ArcBotics/Hexy/README

Hexy the Hexapod is licensed under a Creative Commons Attribution ShareAlike 3.0 United States License.
The full terms of this license can be read at:
http://creativecommons.org/licenses/by-sa/3.0/
