ArcBotics/Hexy/Hexy.SLDASM

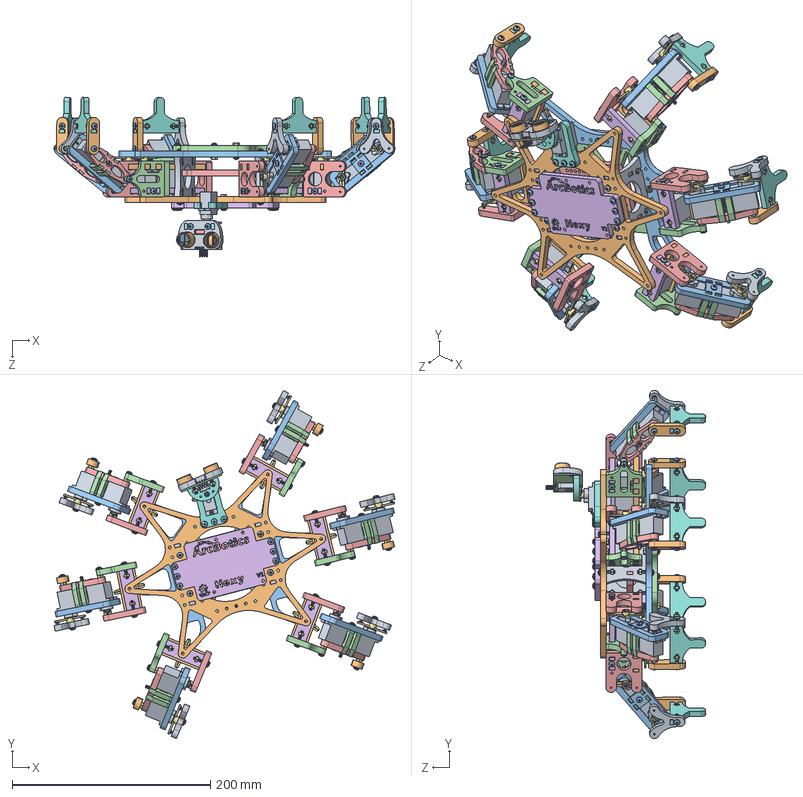
[picture p1: CAD file, 2012-09-01]
Hexy.SLDASM
344.1 x 351.4 x 161.0 mm
Servo x 19
Hip_top_side x 6
Thigh_top x 6
Thigh_middle x 12
Thigh_bottom x 6
M3_35mm_machine_screw x 6
M3_machine_nut x 66
Foot x 6
Calf_horn x 6
Calf_pivot x 6
M3_14mm_machine_screw x 60
Hip_back_side x 6
Hip_horn_side x 6
Hip_pivot_side x 6
Micro Servo Horn Arm x 19
#2_1-4in_sheetmetal_screw x 52
Body_brace x 2
Body_pivot
Body_horn
Battery_bottom
Board plate
Name_plate
Battery_bottom_standoff
Neck_top
Face_plate
Metal_Cone x 2
Grid x 2
HC-SR04_Circuit Board
Crystal
HeaderPinRightAngle x 4
HeaderBody x 4
Neck_bottom
Neck_brace
