ArcBotics/Hexy/Main_body.SLDASM

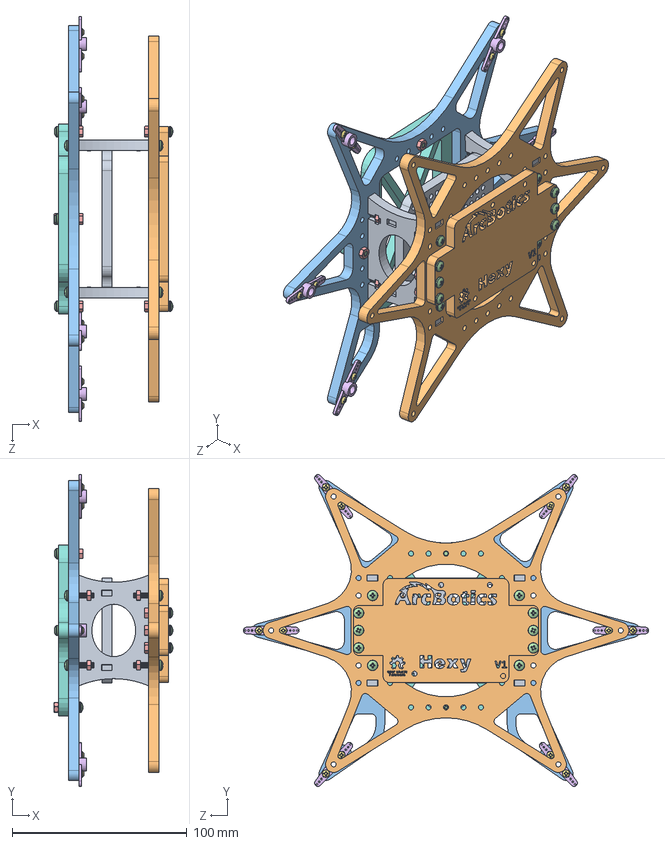
[picture p2: CAD file, 2012-09-01]
Main_body.SLDASM
67.9 x 178.5 x 231.8 mm
Body_brace x 2
Body_pivot
Body_horn
M3_14mm_machine_screw x 18
M3_machine_nut x 18
Micro Servo Horn Arm x 6
#2_1-4in_sheetmetal_screw x 12
Battery_bottom
Board plate
Name_plate
Battery_bottom_standoff
