ArcBotics/Hexy/Head.SLDASM

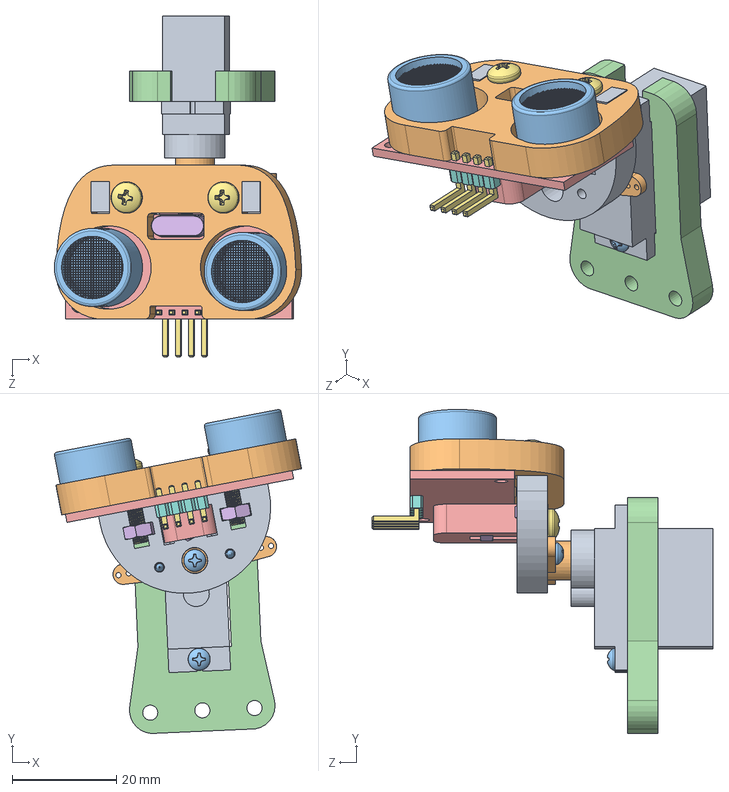
[picture p3: CAD file, 2012-09-01]
Head.SLDASM
47.4 x 62.1 x 65.3 mm
Neck_top
Face_plate
Metal_Cone x 2
Grid x 2
HC-SR04_Circuit Board
Crystal
HeaderPinRightAngle x 4
HeaderBody x 4
Servo
Micro Servo Horn Arm
#2_1-4in_sheetmetal_screw x 4
Neck_bottom
Neck_brace
M3_machine_nut x 3
M3_14mm_machine_screw x 3
