ArcBotics/Hexy/HC-SR04/HeaderPins_4x1.SLDASM

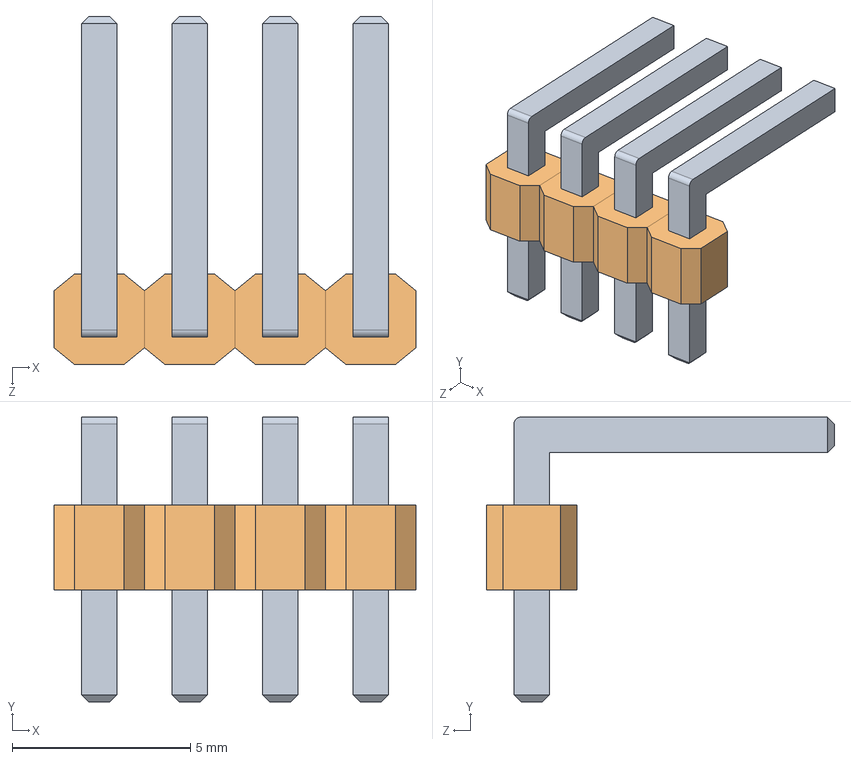
[picture p4: CAD file, 2012-07-19]
HC-SR04/HeaderPins_4x1.SLDASM
10.2 x 8.00 x 9.77 mm
HeaderPinRightAngle x 4
HeaderBody x 4
