ArcBotics/Hexy/Leg.SLDASM

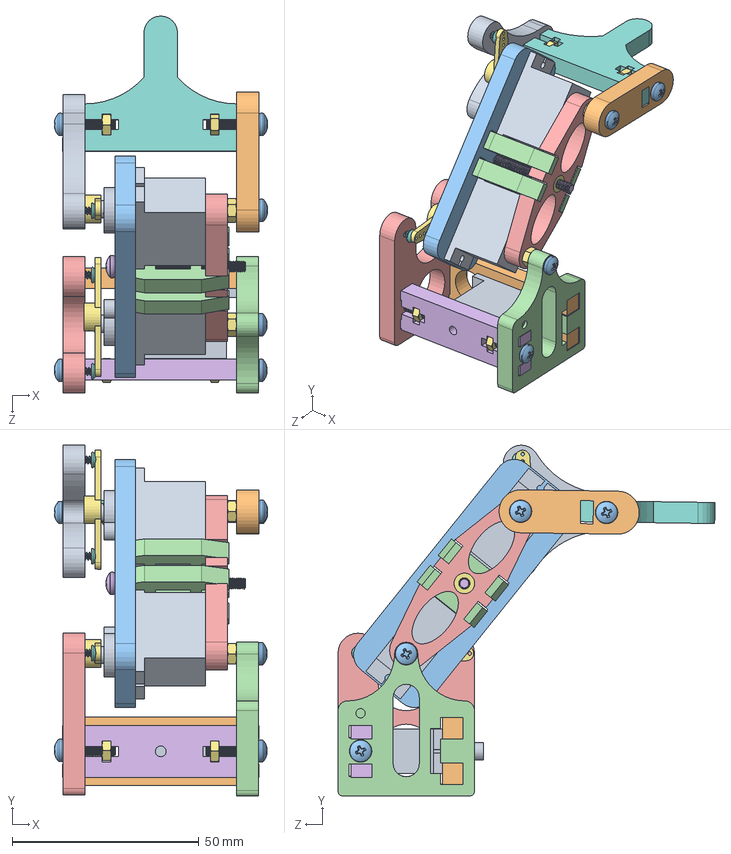
[picture p5: CAD file, 2012-08-26]
Leg.SLDASM
57.0 x 93.8 x 100.8 mm
Servo x 3
Hip_top_side
Thigh_top
Thigh_middle x 2
Thigh_bottom
M3_35mm_machine_screw
M3_machine_nut x 7
Foot
Calf_horn
Calf_pivot
M3_14mm_machine_screw x 6
Hip_back_side
Hip_horn_side
Hip_pivot_side
Micro Servo Horn Arm x 2
#2_1-4in_sheetmetal_screw x 6
