ArcBotics/Hexy/HC-SR04/Sense Cone.SLDASM

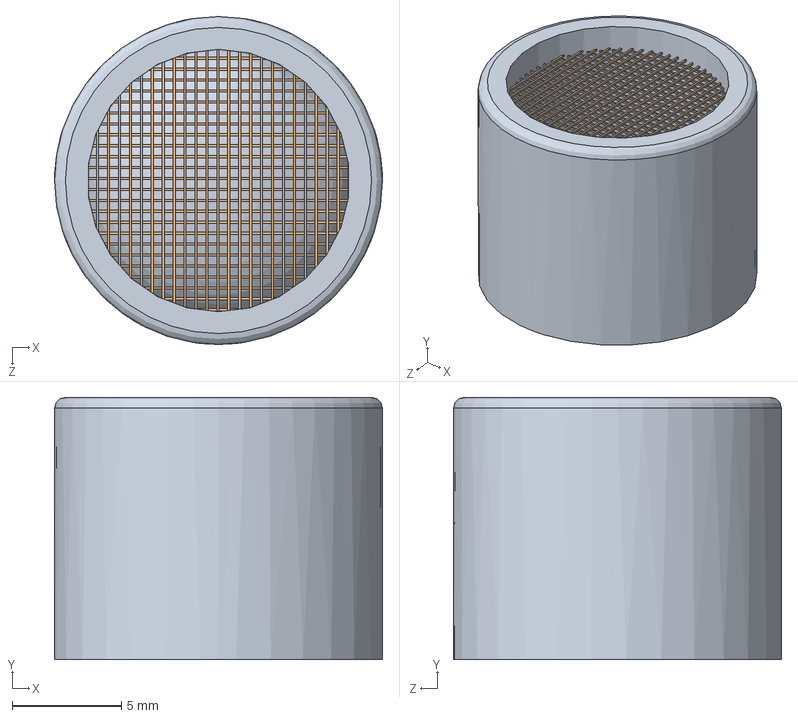
[picture p6: CAD file, 2012-07-19]
HC-SR04/Sense Cone.SLDASM
15.0 x 12.0 x 15.0 mm
Metal_Cone
Grid
