ArcBotics/Hexy/Battery_bottom/Battery_bottom.STEP

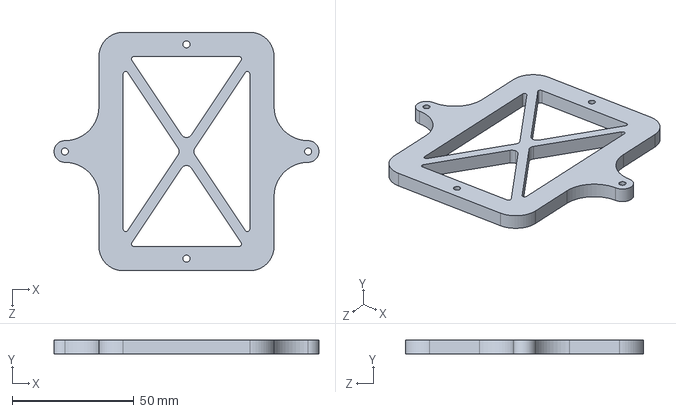
[picture p7: CAD file, 2019-05-07]
Battery_bottom/Battery_bottom.STEP
108.9 x 5.85 x 98.0 mm
