ArcBotics/Hexy/Battery_bottom_standoff/Battery_bottom_standoff.STEP

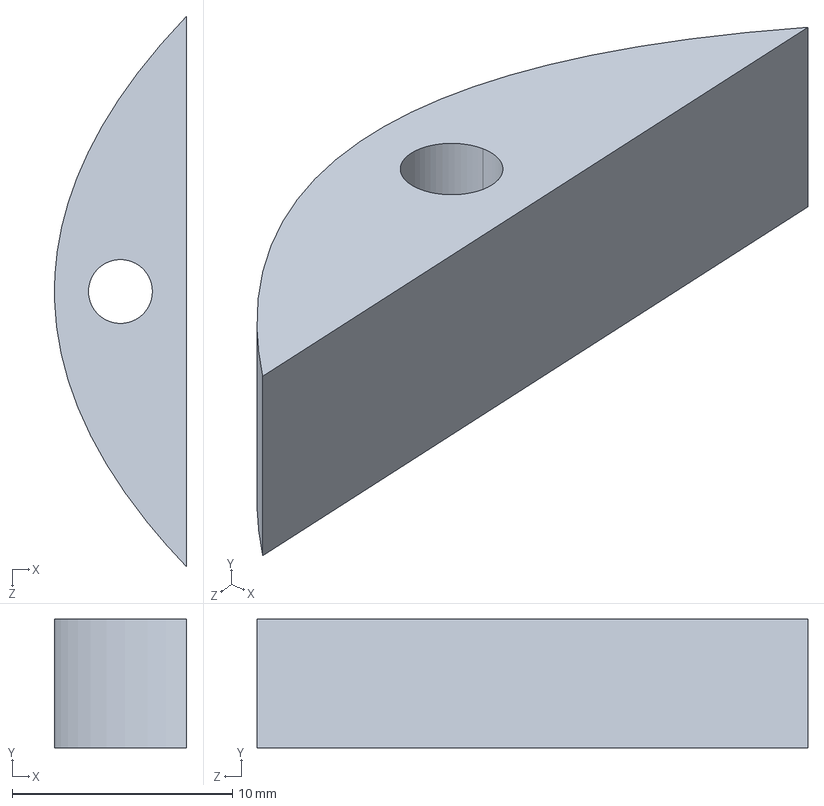
[picture p8: CAD file, 2019-05-07]
Battery_bottom_standoff/Battery_bottom_standoff.STEP
5.99 x 5.85 x 25.0 mm
