ArcBotics/Hexy/Board plate/Board plate.STEP

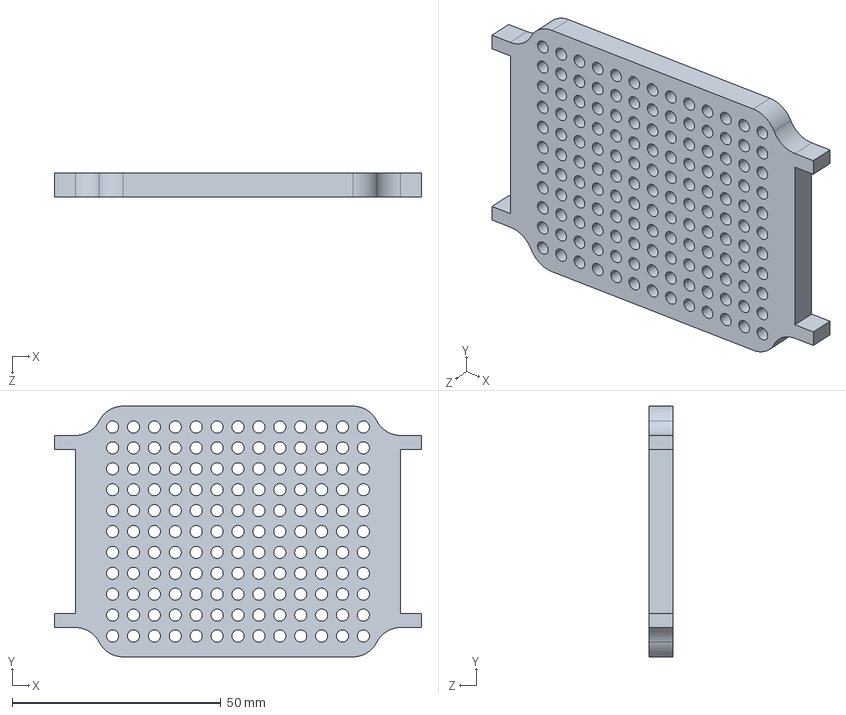
[picture p9: CAD file, 2019-05-07]
Board plate/Board plate.STEP
87.8 x 60.0 x 5.85 mm
