ArcBotics/Hexy/Body_brace/Body_brace.STEP

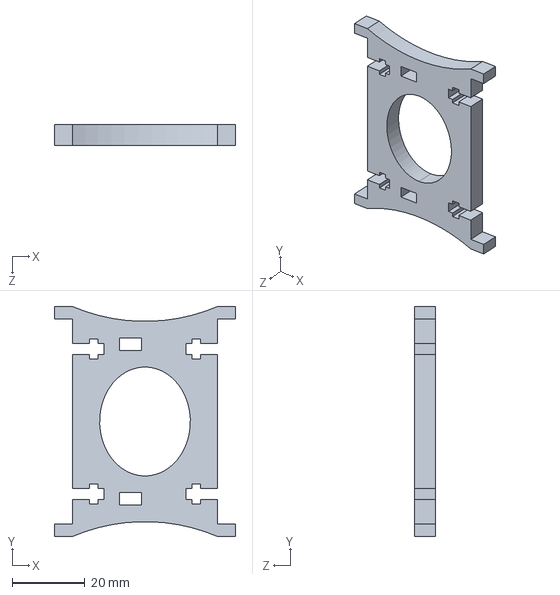
[picture p10: CAD file, 2019-05-07]
Body_brace/Body_brace.STEP
50.0 x 63.4 x 5.85 mm
