ArcBotics/Hexy/Body_horn/Body_horn.STEP

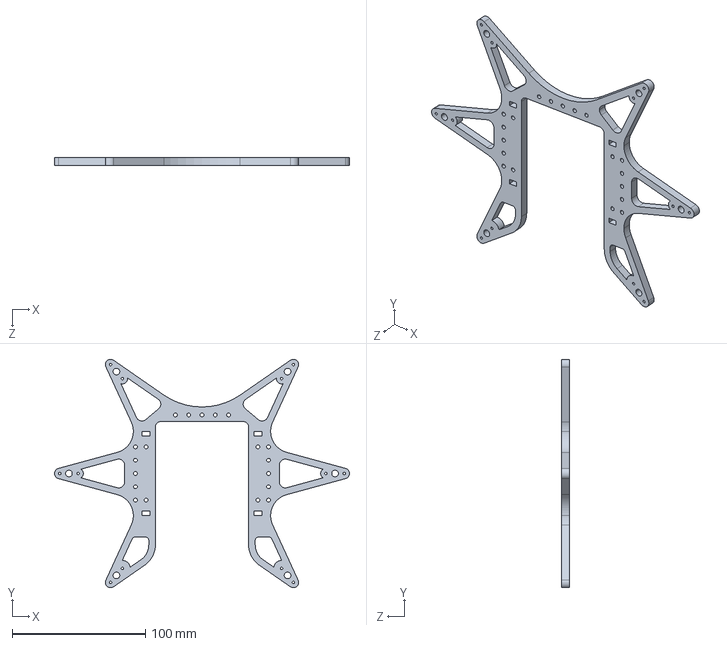
[picture p11: CAD file, 2019-05-07]
Body_horn/Body_horn.STEP
221.7 x 171.7 x 5.85 mm
