ArcBotics/Hexy/Body_pivot/Body_pivot.STEP

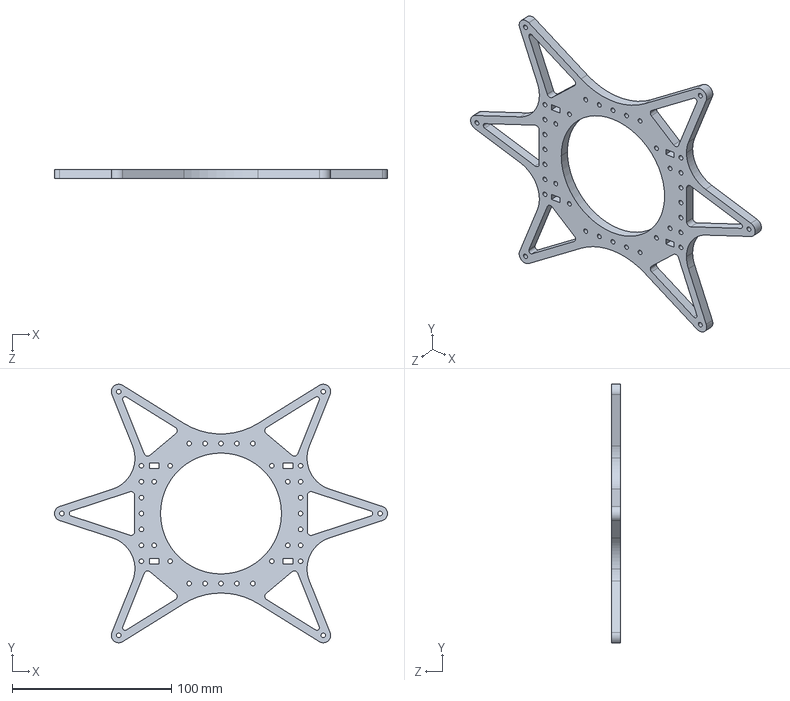
[picture p12: CAD file, 2019-05-07]
Body_pivot/Body_pivot.STEP
209.3 x 162.5 x 5.85 mm
