ArcBotics/Hexy/Calf_horn/Calf_horn.STEP

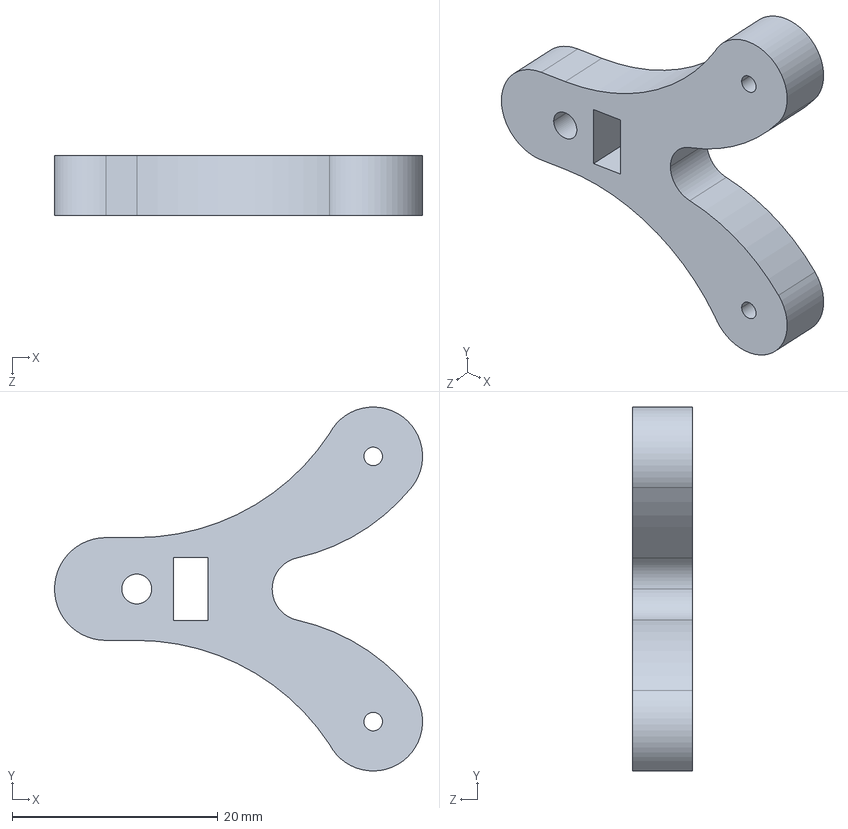
[picture p13: CAD file, 2019-05-07]
Calf_horn/Calf_horn.STEP
35.8 x 35.4 x 5.85 mm
