ArcBotics/Hexy/Calf_pivot/Calf_pivot.STEP

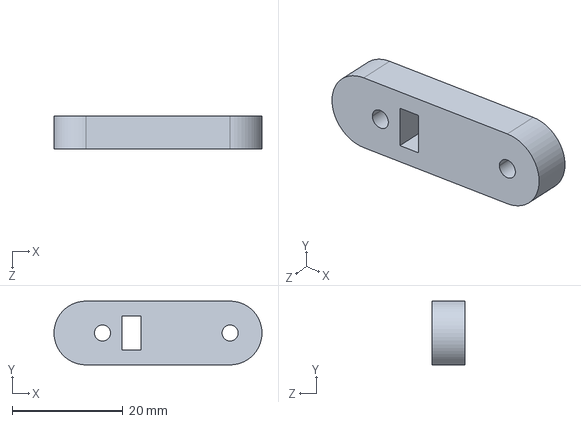
[picture p14: CAD file, 2019-05-07]
Calf_pivot/Calf_pivot.STEP
37.5 x 11.5 x 6.00 mm
