ArcBotics/Hexy/Face_plate/Face_plate.STEP

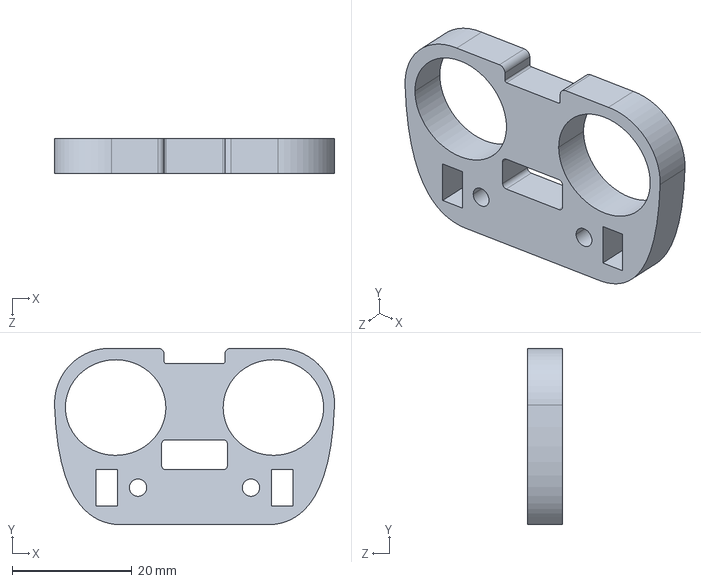
[picture p15: CAD file, 2019-05-07]
Face_plate/Face_plate.STEP
46.9 x 29.5 x 5.85 mm
