ArcBotics/Hexy/Foot/Foot.STEP

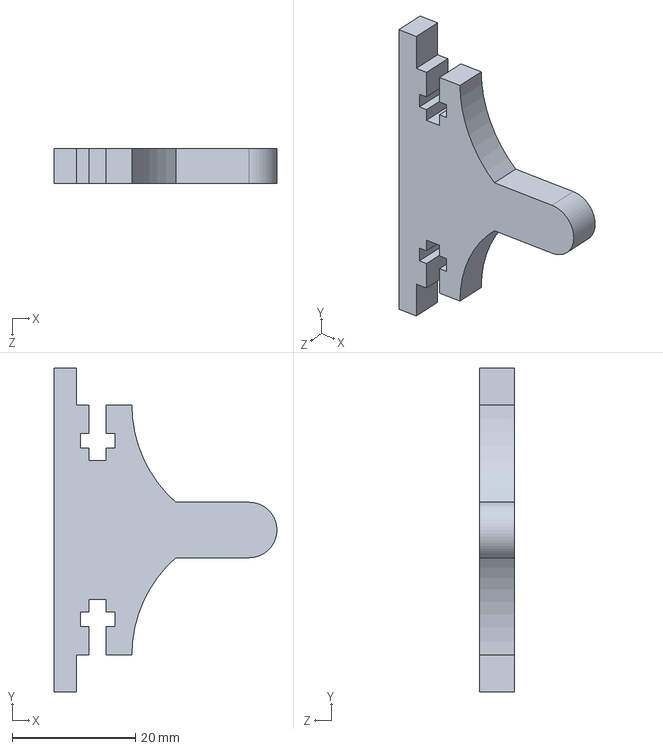
[picture p16: CAD file, 2019-05-07]
Foot/Foot.STEP
36.1 x 52.5 x 5.64 mm
