ArcBotics/Hexy/HC-SR04/HC-SR04.STEP

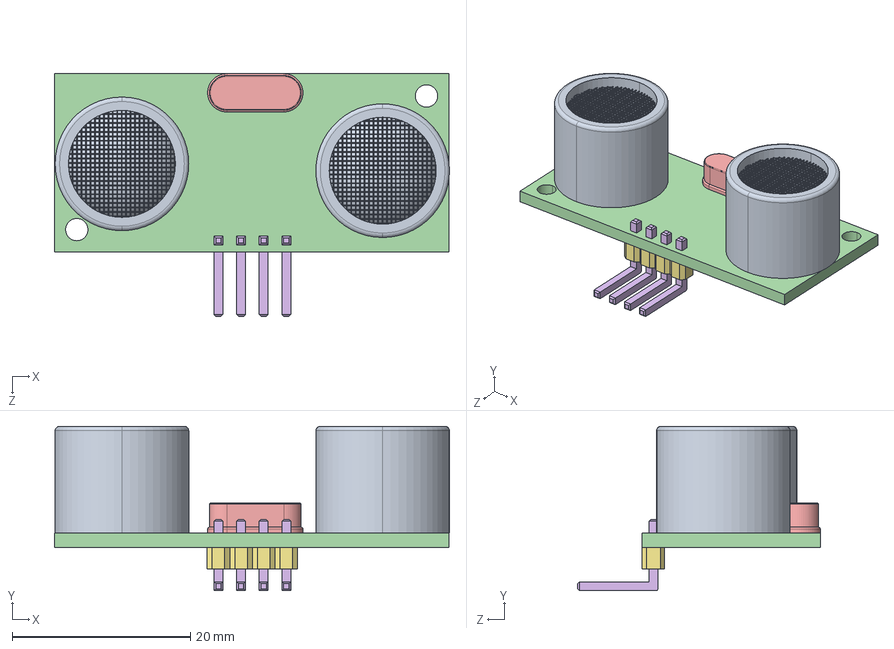
[picture p17: CAD file, 2019-05-07]
HC-SR04/HC-SR04.STEP
44.3 x 18.5 x 27.2 mm
Metal_Cone x 2
Grid x 2
HC-SR04_Circuit Board
Crystal
HeaderPinRightAngle x 4
HeaderBody x 4
