ArcBotics/Hexy/Hip_back_side/Hip_back_side.STEP

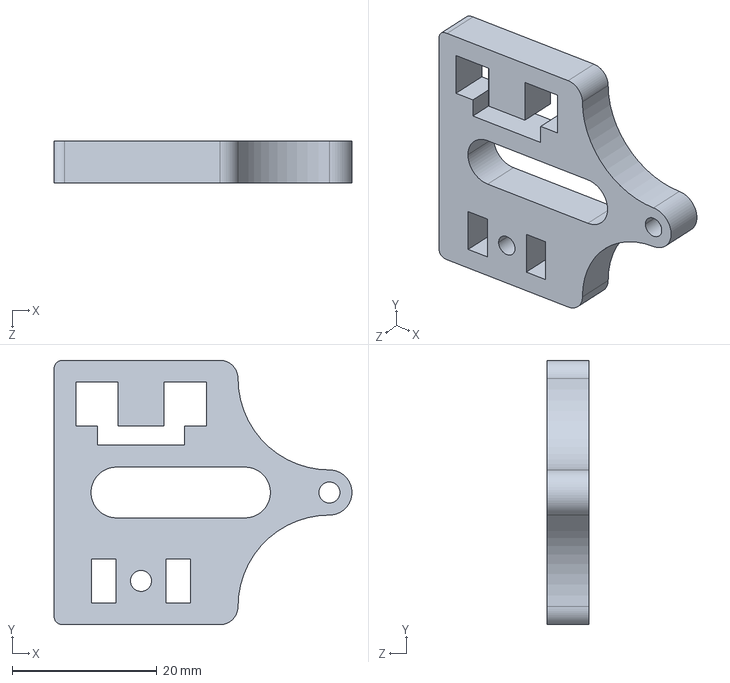
[picture p18: CAD file, 2019-05-07]
Hip_back_side/Hip_back_side.STEP
41.1 x 36.5 x 5.85 mm
