ArcBotics/Hexy/Hip_horn_side/Hip_horn_side.STEP

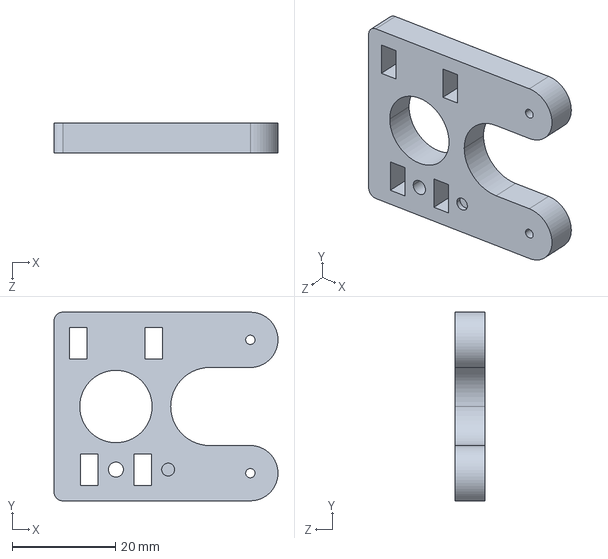
[picture p19: CAD file, 2019-05-07]
Hip_horn_side/Hip_horn_side.STEP
43.3 x 36.5 x 5.85 mm
