ArcBotics/Hexy/Hip_pivot_side/Hip_pivot_side.STEP

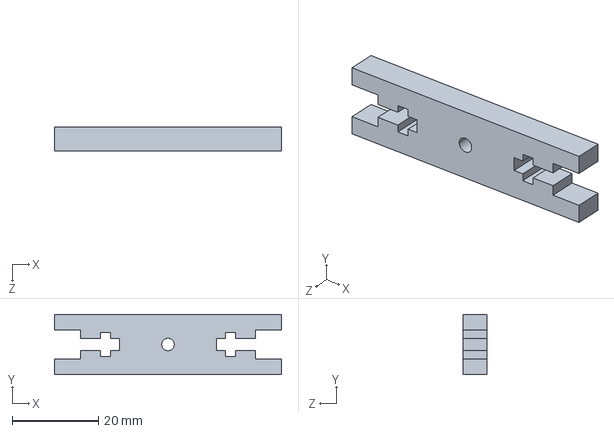
[picture p20: CAD file, 2019-05-07]
Hip_pivot_side/Hip_pivot_side.STEP
52.5 x 13.9 x 5.64 mm
