ArcBotics/Hexy/Hip_top_side/Hip_top_side.STEP

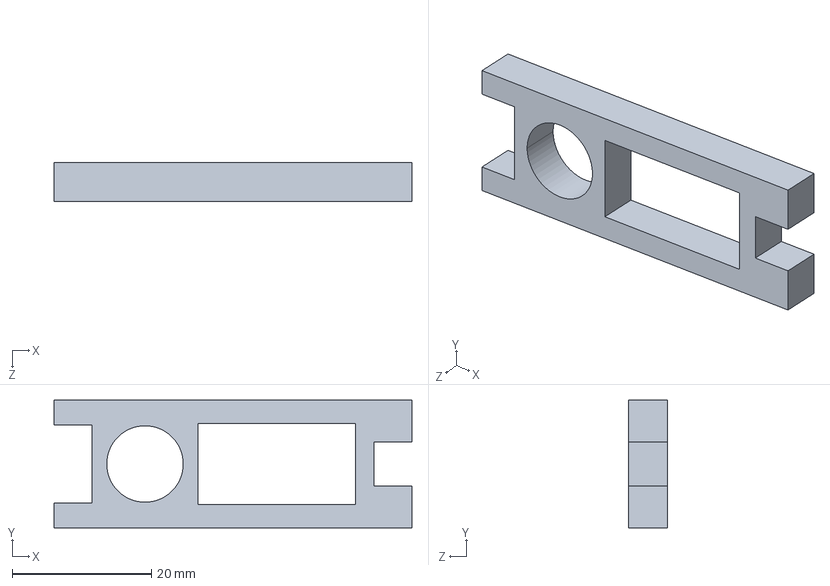
[picture p21: CAD file, 2019-05-07]
Hip_top_side/Hip_top_side.STEP
51.5 x 18.4 x 5.60 mm
