ArcBotics/Hexy/Name_plate/Name_plate.SLDPRT

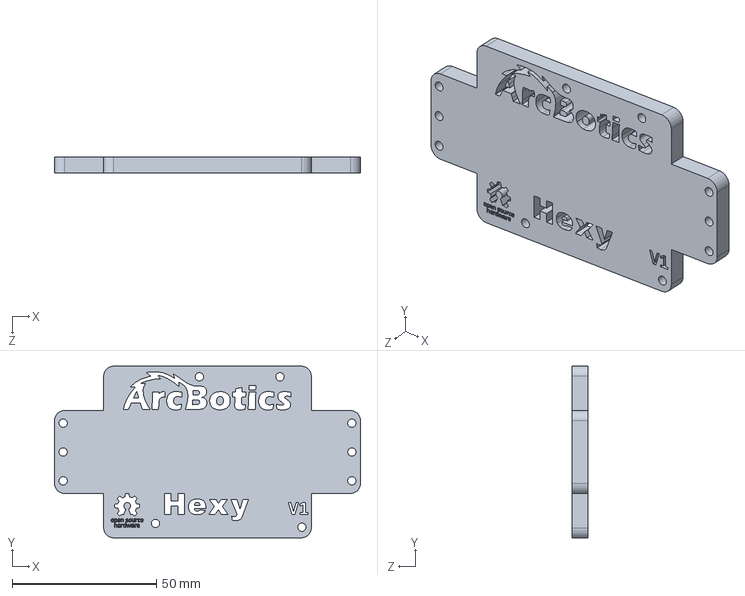
[picture p22: CAD file, 2012-09-22]
Name_plate/Name_plate.SLDPRT
106.0 x 59.5 x 5.60 mm
