ArcBotics/Hexy/Neck_bottom/Neck_bottom.STEP

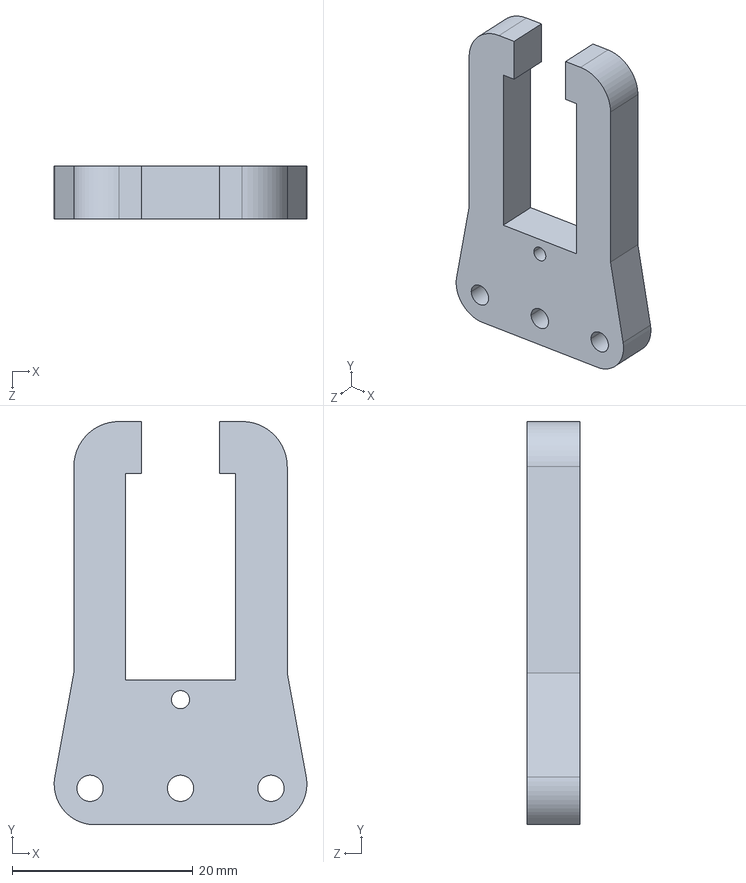
[picture p23: CAD file, 2019-05-07]
Neck_bottom/Neck_bottom.STEP
27.9 x 44.6 x 5.85 mm
