ArcBotics/Hexy/Neck_brace/Neck_brace.SLDPRT

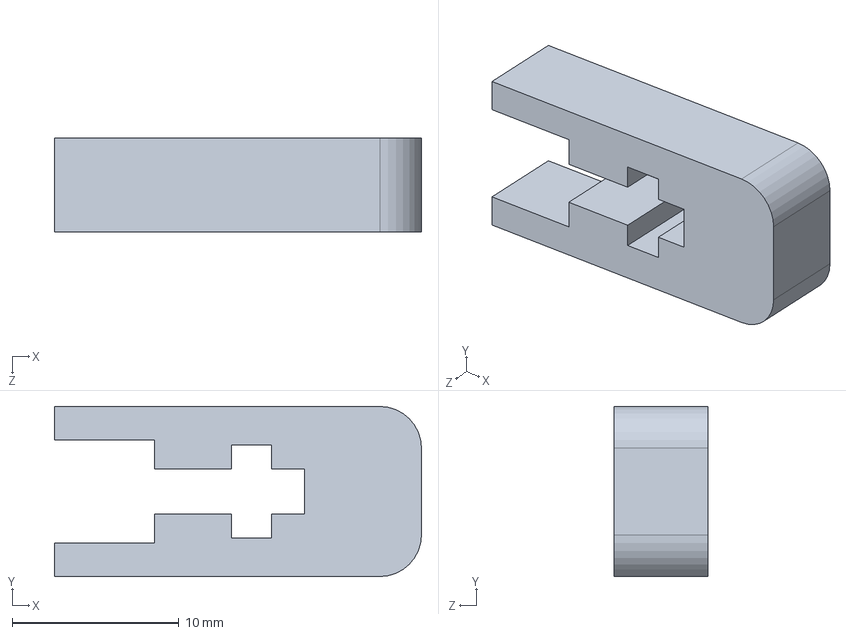
[picture p24: CAD file, 2012-07-27]
Neck_brace/Neck_brace.SLDPRT
22.0 x 10.2 x 5.64 mm
