ArcBotics/Hexy/Neck_top/Neck_top.SLDPRT

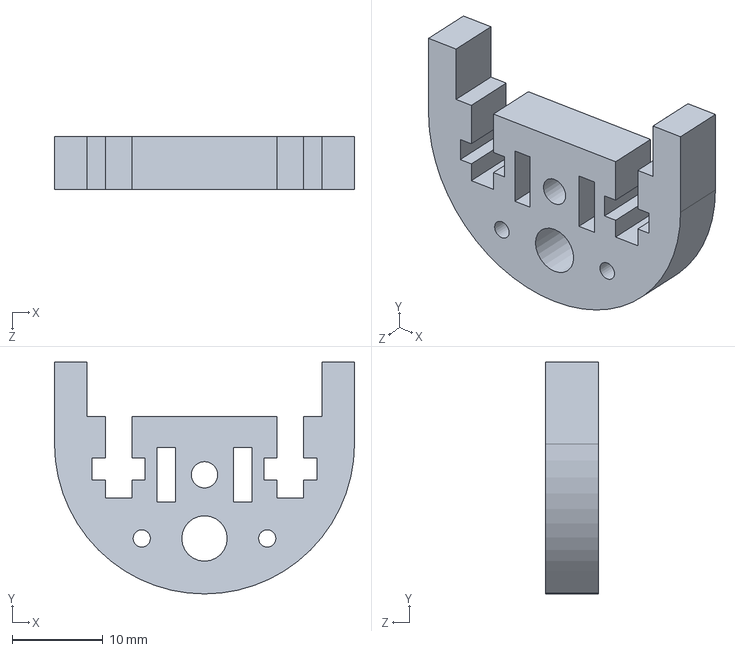
[picture p25: CAD file, 2012-07-27]
Neck_top/Neck_top.SLDPRT
33.0 x 25.5 x 5.85 mm
