ArcBotics/Hexy/Servo/Servo.STEP

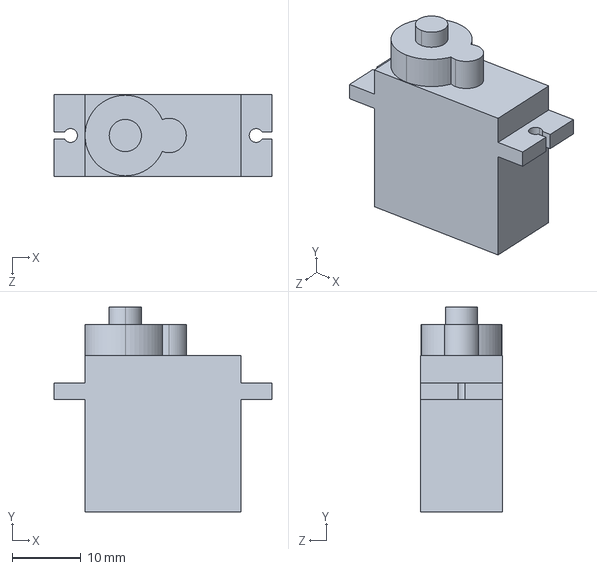
[picture p26: CAD file, 2019-05-07]
Servo/Servo.STEP
31.6 x 29.7 x 11.8 mm
