ArcBotics/Hexy/Thigh_bottom/Thigh_bottom.STEP

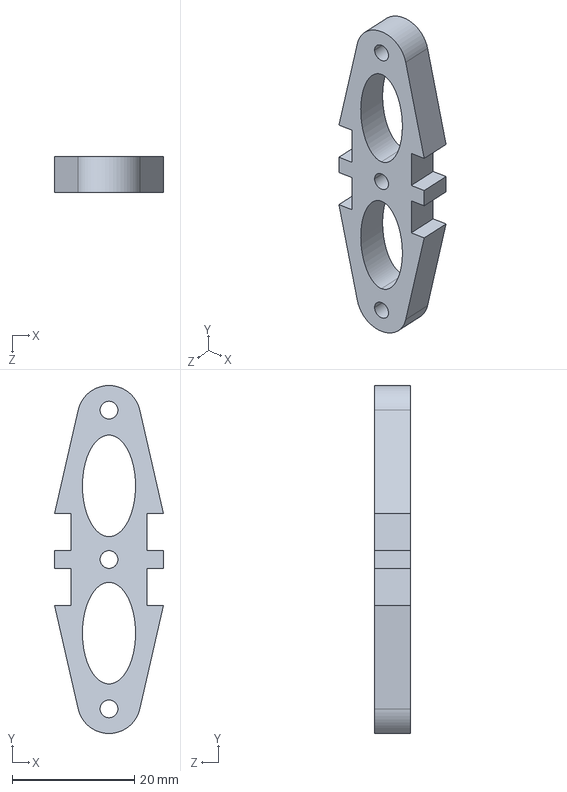
[picture p27: CAD file, 2019-05-07]
Thigh_bottom/Thigh_bottom.STEP
17.8 x 56.9 x 5.85 mm
