ArcBotics/Hexy/Thigh_middle/Thigh_middle.STEP

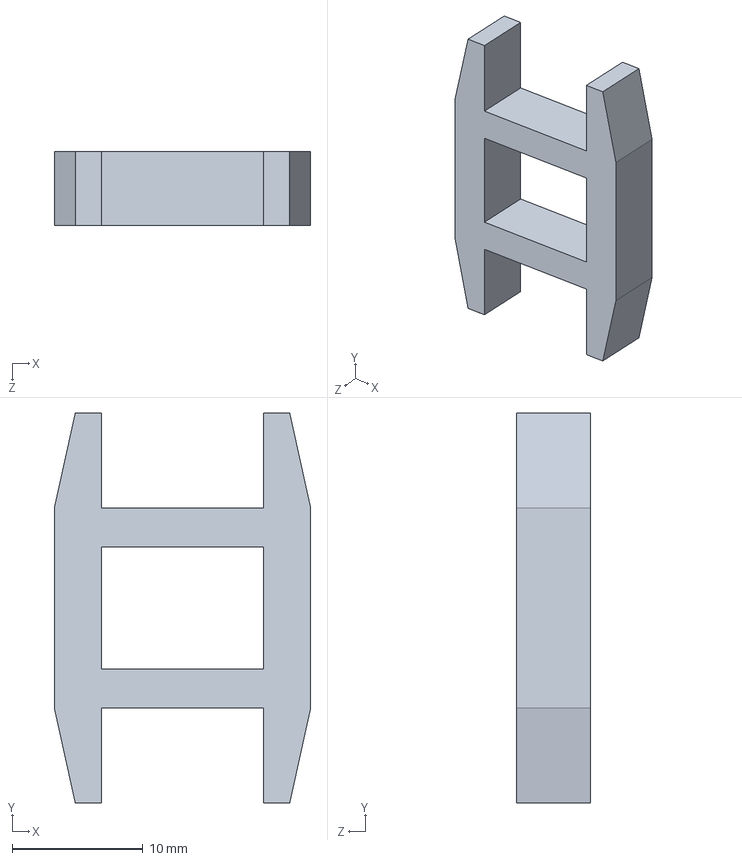
[picture p28: CAD file, 2019-05-07]
Thigh_middle/Thigh_middle.STEP
19.6 x 29.8 x 5.64 mm
