ArcBotics/Hexy/Thigh_top/Thigh_top.STEP

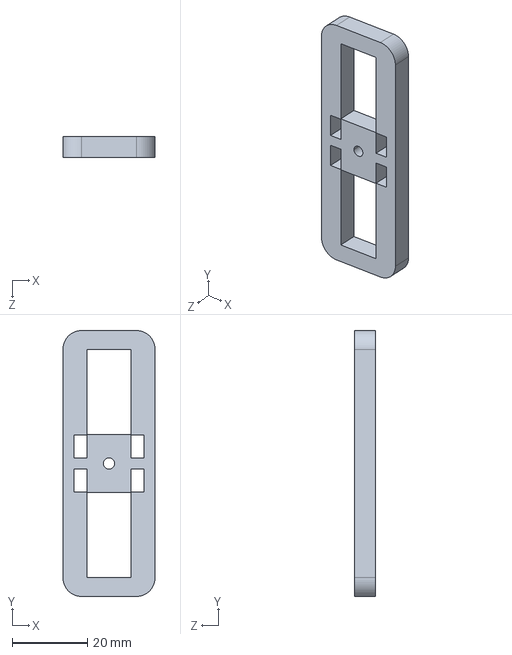
[picture p29: CAD file, 2019-05-07]
Thigh_top/Thigh_top.STEP
24.5 x 70.7 x 5.58 mm
