ArcBotics/Hexy/HC-SR04/HeaderBody.SLDPRT

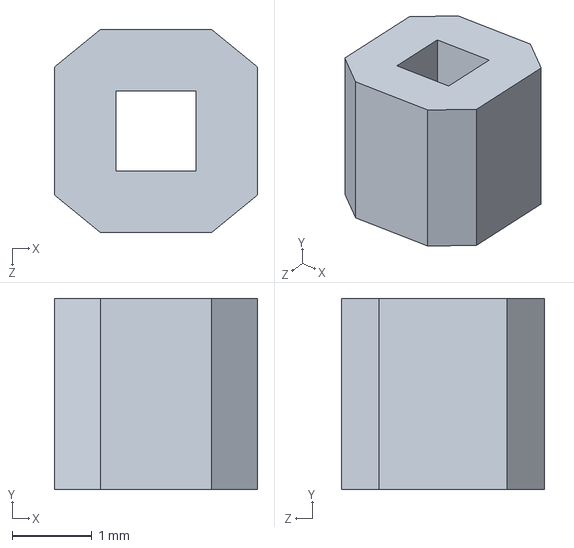
[picture p30: CAD file, 2012-07-19]
HC-SR04/HeaderBody.SLDPRT
2.54 x 2.39 x 2.54 mm
