ArcBotics/Hexy/Servo/Micro Servo Horn Arm.SLDPRT

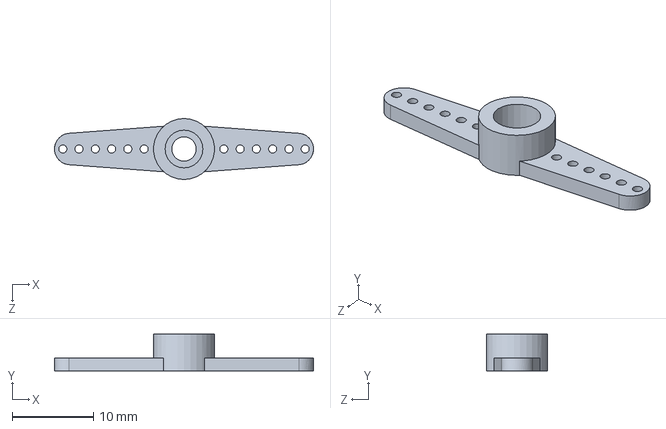
[picture p31: CAD file, 2012-07-24]
Servo/Micro Servo Horn Arm.SLDPRT
31.8 x 4.50 x 7.50 mm
