ArcBotics/Hexy/HC-SR04/HC-SR04_Circuit Board.SLDPRT

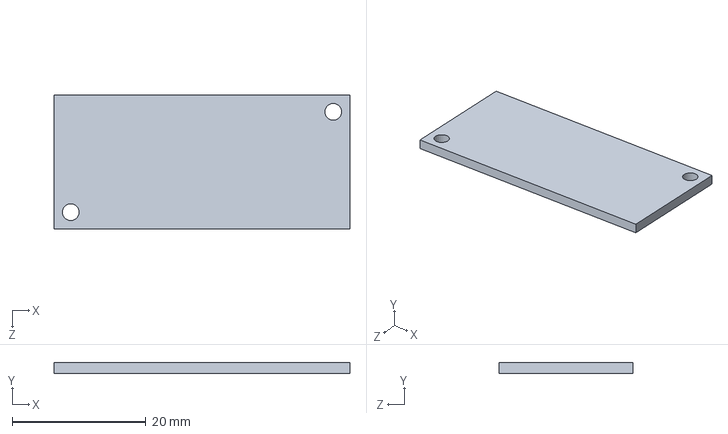
[picture p32: CAD file, 2012-07-19]
HC-SR04/HC-SR04_Circuit Board.SLDPRT
44.2 x 1.60 x 20.0 mm
