ArcBotics/Hexy/HC-SR04/HeaderPinRightAngle.SLDPRT

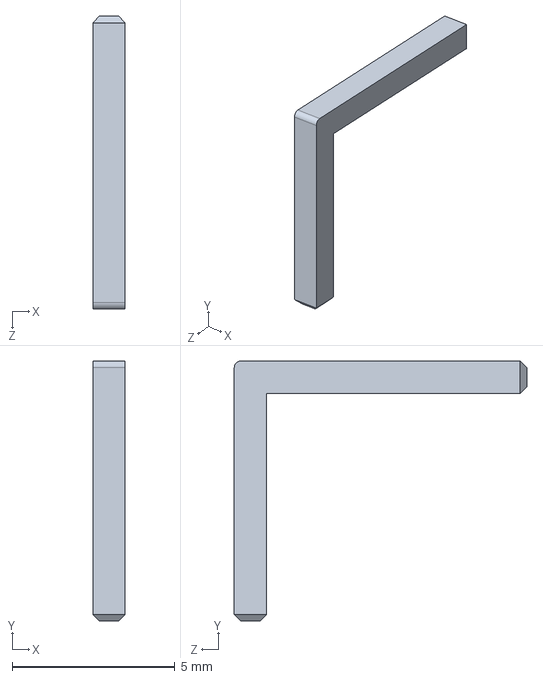
[picture p33: CAD file, 2012-07-19]
HC-SR04/HeaderPinRightAngle.SLDPRT
1.00 x 8.00 x 9.00 mm
