ArcBotics/Hexy/HC-SR04/Grid.SLDPRT

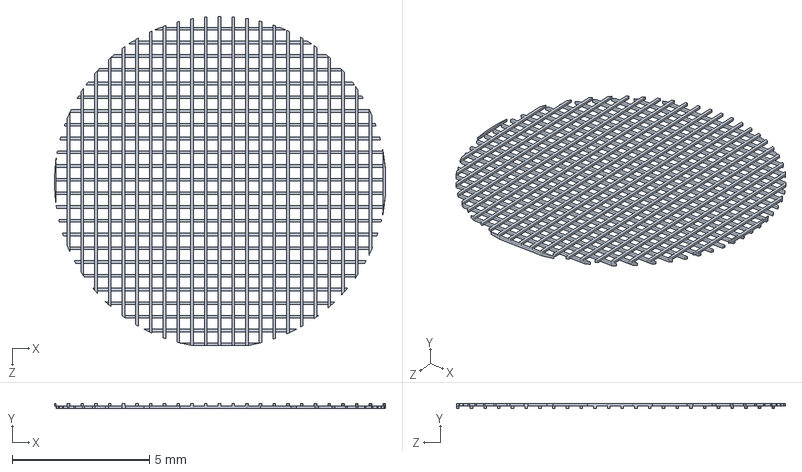
[picture p34: CAD file, 2012-07-19]
HC-SR04/Grid.SLDPRT
12.1 x 0.2 x 12.0 mm
