ArcBotics/Hexy/HC-SR04/Metal_Cone.SLDPRT

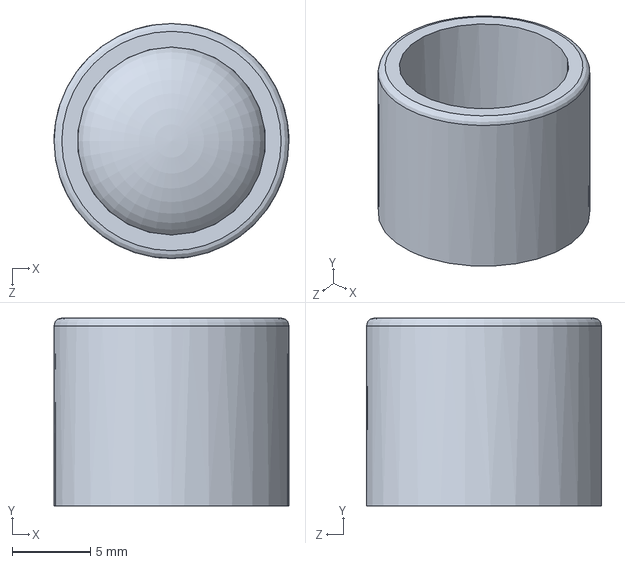
[picture p35: CAD file, 2012-07-19]
HC-SR04/Metal_Cone.SLDPRT
15.0 x 12.0 x 15.0 mm
