ArcBotics/Hexy/HC-SR04/Crystal.SLDPRT

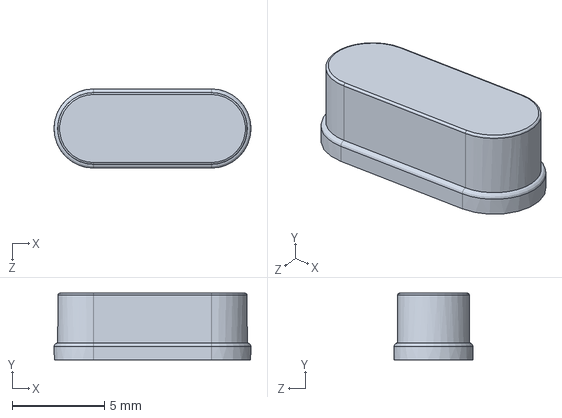
[picture p36: CAD file, 2012-07-19]
HC-SR04/Crystal.SLDPRT
10.7 x 3.62 x 4.30 mm
