ArcBotics/Hexy/(list of files, cad)

Other CAD files:
Battery_bottom/Battery_bottom.DXF
Battery_bottom/Battery_bottom.SLDPRT
Battery_bottom/Battery_bottom.STL
Battery_bottom_standoff/Battery_bottom_standoff.DXF
Battery_bottom_standoff/Battery_bottom_standoff.SLDPRT
Battery_bottom_standoff/Battery_bottom_standoff.STL
Board plate/Board plate.DXF
Board plate/Board plate.SLDPRT
Board plate/Board plate.STL
Body_brace/Body_brace.DXF
Body_brace/Body_brace.SLDPRT
Body_brace/Body_brace.STL
Body_horn/Body_horn.DXF
Body_horn/Body_horn.SLDPRT
Body_horn/Body_horn.STL
Body_pivot/Body_pivot.DXF
Body_pivot/Body_pivot.SLDPRT
Body_pivot/Body_pivot.STL
Calf_horn/Calf_horn.DXF
Calf_horn/Calf_horn.SLDPRT
Calf_horn/Calf_horn.STL
Calf_pivot/Calf_pivot.DXF
Calf_pivot/Calf_pivot.SLDPRT
Calf_pivot/Calf_pivot.STL
Face_plate/Face_plate.DXF
Face_plate/Face_plate.SLDPRT
Face_plate/Face_plate.STL
Foot/Foot.DXF
Foot/Foot.SLDPRT
Foot/Foot.STL
HC-SR04/HC-SR04.SLDASM
Hip_back_side/Hip_back_side.DXF
Hip_back_side/Hip_back_side.SLDPRT
Hip_back_side/Hip_back_side.STL
Hip_horn_side/Hip_horn_side.DXF
Hip_horn_side/Hip_horn_side.SLDPRT
Hip_horn_side/Hip_horn_side.STL
Hip_pivot_side/Hip_pivot_side.DXF
Hip_pivot_side/Hip_pivot_side.SLDPRT
Hip_pivot_side/Hip_pivot_side.STL
Hip_top_side/Hip_top_side.DXF
Hip_top_side/Hip_top_side.SLDPRT
Hip_top_side/Hip_top_side.STL
Name_plate/Name_plate.DXF
Name_plate/Name_plate.STL
Neck_bottom/Neck_bottom.DXF
Neck_bottom/Neck_bottom.SLDPRT
Neck_bottom/Neck_bottom.STL
Neck_brace/Neck_brace.DXF
Neck_brace/Neck_brace.STL
Neck_top/Neck_top.DXF
Neck_top/Neck_top.STL
Screwdriver grip/Screwdriver grip.DXF
Screwdriver grip/Screwdriver grip.SLDPRT
Screwdriver grip/Screwdriver grip.STEP
Screws-Nuts/#2_1-4in_sheetmetal_screw.SLDPRT
Screws-Nuts/M3_14mm_machine_screw.SLDPRT
Screws-Nuts/M3_35mm_machine_screw.SLDPRT
Screws-Nuts/M3_machine_nut.SLDPRT
Servo/Micro Servo Horn Arm.STL
Servo/Servo.SLDPRT
Servo/Servo.STL
Thigh_bottom/Thigh_bottom.SLDPRT
Thigh_bottom/Thigh_bottom.STL
Thigh_bottom/Thigh_bottom.dxf
Thigh_middle/Thigh_middle.DXF
Thigh_middle/Thigh_middle.SLDPRT
Thigh_middle/Thigh_middle.STL
Thigh_top/Thigh_top.SLDPRT
Thigh_top/Thigh_top.STL
Thigh_top/Thigh_top.dxf
