ArcBotics/Hexy/(commit log)

2012-04-14 Hexy RC1 files
    [Body_brace.SLDPRT, Body_brace.STL, Body_brace.dxf, Body_horn.SLDPRT, Body_horn.dxf, Body_horn_six.DXF, Body_horn_six.SLDPRT, Body_pivot.dxf]
2012-07-19 Clearing out old files before uploading the current rev under VC.
    [Body_brace.SLDPRT, Body_brace.STL, Body_brace.dxf, Body_horn.SLDPRT, Body_horn.dxf, Body_horn_six.DXF, Body_horn_six.SLDPRT, Body_pivot.dxf]
2012-07-19 Initial commit of Revision 14.
    [#2_1-4in_sheetmetal_screw.SLDPRT, Battery_bottom.DXF, Battery_bottom.SLDPRT, Battery_bottom.STL, Battery_bottom_standoff.DXF, Battery_bottom_standoff.SLDPRT, Battery_bottom_standoff.STL, Body_brace.DXF]
2012-07-19 Directory hierarchy restructuring.
    [#2_1-4in_sheetmetal_screw.SLDPRT, Battery_bottom.DXF, Battery_bottom.SLDPRT, Battery_bottom.STL, Battery_bottom_standoff.DXF, Battery_bottom_standoff.SLDPRT, Battery_bottom_standoff.STL, Body_brace.DXF]
2012-07-19 Fixed a bunch of the machine screw mates for the body braces.
    [Main_body.SLDASM]
2012-07-19 Set material color for the battery holder/standoffs.
    [Battery_bottom.SLDPRT, Battery_bottom_standoff.SLDPRT]
2012-07-19 Fixed all broken mates in the leg assembly.
    [Leg.SLDASM, M3_35mm_machine_screw.SLDPRT]
2012-07-19 New servo horn model finished.
    This is sized for the white servo horns shipped with the HTX900 plastic gear servos.
    Horns will be swapped in the assembly pending verification that the newest servo horns are an exact match.
    [Micro Servo Horn Arm - new model WIP.SLDPRT]
2012-07-20 Increased spacing between battery holder side mounting screws.
    [Battery_bottom.DXF, Battery_bottom.SLDPRT, Battery_bottom_standoff.DXF, Battery_bottom_standoff.SLDPRT, Body_horn.DXF, Body_horn.SLDPRT]
2012-07-20 Tweaked neck_top mounting hole position.
    This should fit the rangefinder PCB more snugly.
    [Face_plate.DXF, Face_plate.SLDPRT]
2012-07-20 Blanket updating DXF files for packing purposes.
    [Body_brace.DXF, Body_pivot.DXF, Calf_horn.DXF, Calf_pivot.DXF, Foot.DXF, Hip_back_side.DXF, Hip_horn_side.DXF, Hip_pivot_side.DXF]
2012-07-22 Fixed most of the undefined sketch elements in the body pieces.
    [Body_brace.DXF, Body_brace.SLDPRT, Body_horn.DXF, Body_horn.SLDPRT, Body_pivot.DXF, Body_pivot.SLDPRT, Main_body.SLDASM]
2012-07-22 Updated STL models for all parts.
    [Battery_bottom.STL, Battery_bottom_standoff.STL, Body_brace.STL, Body_horn.STL, Body_pivot.STL, Calf_horn.STL, Calf_pivot.STL, Face_plate.STL]
2012-07-22 Defined more body brace sketch elements.
    [Body_brace.DXF, Body_brace.SLDPRT]
2012-07-22 Reduced the width of the bottom battery holder for easier packing.
    [Battery_bottom.DXF, Battery_bottom.SLDPRT, Battery_bottom.STL]
2012-07-22 Fully defined the Thigh_middle sketch.
    [Thigh_middle.DXF, Thigh_middle.SLDPRT]
2012-07-22 Resized thigh_middle to fit the plastic servos.
    The new sizing is based on the thigh_middle piece from the Rev13 orange plastic servo prototype.
    [Thigh_middle.DXF, Thigh_middle.SLDPRT, Thigh_middle.STL]
2012-07-22 Thigh_top sketch fully defined.
    [Thigh_top.SLDPRT, Thigh_top.dxf]
2012-07-22 Servo dimensions explicitly defined.
    [Servo.SLDPRT]
2012-07-22 Thigh_bottom sketch fully defined.
    [Thigh_bottom.SLDPRT, Thigh_bottom.STL, Thigh_bottom.dxf]
2012-07-22 Reduced the length of thigh_bottom for improved pivot screw alignment.
    [Thigh_bottom.SLDPRT, Thigh_bottom.STL, Thigh_bottom.dxf]
2012-07-22 Calf_horn sketch fully defined.
    [Calf_horn.DXF, Calf_horn.SLDPRT, Calf_horn.STL]
2012-07-22 Calf_pivot sketch fully defined.
    [Calf_pivot.DXF, Calf_pivot.SLDPRT, Calf_pivot.STL]
2012-07-24 Neck_top sketch fully defined.
    [Neck_top.DXF, Neck_top.SLDPRT, Neck_top.STL]
2012-07-24 Updated servo horn model to production version.
    [Micro Servo Horn Arm - new model WIP.SLDPRT, Micro Servo Horn Arm.SLDPRT, Micro Servo Horn Arm.STL]
2012-07-24 Foot sketch fully defined.
    [Foot.DXF, Foot.SLDPRT, Foot.STL]
2012-07-24 Updated all horn mounting holes to match the production servo horns.
    [Body_horn.DXF, Body_horn.SLDPRT, Body_horn.STL, Calf_horn.DXF, Calf_horn.SLDPRT, Calf_horn.STL, Hip_horn_side.DXF, Hip_horn_side.SLDPRT]
2012-07-24 Hip_horn_side sketch fully defined.
    [Hip_horn_side.DXF, Hip_horn_side.SLDPRT, Hip_horn_side.STL]
2012-07-24 Fixed revised thigh_bottom hole spacing.
    Dimension value was based off of the edge of the center hole, while the real dimension was from the hole center.
    [Servo.SLDPRT, Thigh_bottom.SLDPRT, Thigh_bottom.STL, Thigh_bottom.dxf]
2012-07-24 Added a notch to Face_plate to accomodate the bottom of the rangefinder IO pins.
    This should allow the rangefinder to mount flush.
    [Face_plate.DXF, Face_plate.SLDPRT, Face_plate.STL]
2012-07-24 Hip_top_side sketch fully defined.
    The existing sketch was such a mess of unused construction lines and undeletable points
    that I saved the dimensions and redid it from scratch.
    [Hip_top_side.DXF, Hip_top_side.SLDPRT, Hip_top_side.STL]
2012-07-24 Hip_pivot_side sketch fully defined.
    [Hip_pivot_side.DXF, Hip_pivot_side.SLDPRT]
2012-07-24 Hip_back_side sketch fully defined.
    [Hip_back_side.DXF, Hip_back_side.SLDPRT, Hip_back_side.STL]
2012-07-24 Fixed extra space in hip servo mounting area.
    This moves Hip_top_side and Hip_pivot_side closer together to fit the production servos.
    [Hip_back_side.DXF, Hip_back_side.SLDPRT, Hip_back_side.STL, Hip_horn_side.DXF, Hip_horn_side.SLDPRT, Hip_horn_side.STL]
2012-07-25 Improved fitting between hip components.
    [Hip_back_side.DXF, Hip_back_side.SLDPRT, Hip_back_side.STL, Hip_horn_side.DXF, Hip_horn_side.SLDPRT, Hip_horn_side.STL, Hip_pivot_side.DXF, Hip_pivot_side.SLDPRT]
2012-07-27 Explicitly defined (and reduced) the height of Body_brace.
    The Body_pivot hip pivot screws aren't quite reaching like they should.
    [Body_brace.DXF, Body_brace.SLDPRT, Body_brace.STL, Body_horn.DXF, Body_pivot.DXF, Body_pivot.SLDPRT]
2012-07-27 Widened the faceplate eye sockets to fit both rangefinder revisions.
    [Face_plate.DXF, Face_plate.SLDPRT, Face_plate.STL]
2012-07-27 Neck_bottom sketch fully defined.
    [Neck_bottom.DXF, Neck_bottom.SLDPRT, Neck_bottom.STL]
2012-07-27 Improved mounting mechanism for the rangefinder.
    Neck_brace is a small piece of acrylic that mounts vertically up from Neck_top.
    The side of Neck_brace fits snugly against an IC on the back of the rangefinder, safely holding it in place.
    Additions to BOM:
    -Neck_brace acrylic piece (1).
    -M3x14mm machine screw (1).
    -M3 machine nut (1).
    [Face_plate.SLDPRT, Face_plate.STL, Head.SLDASM, Neck_bottom.DXF, Neck_bottom.SLDPRT, Neck_bottom.STL, Neck_brace.DXF, Neck_brace.SLDPRT]
2012-07-27 Screwing down the head servo.
    -#2 x 1/4 sheet metal screw (1).
    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
    [Neck_bottom.DXF, Neck_bottom.SLDPRT, Neck_bottom.STL]
2012-07-28 Remodeled the nameplate in SolidWorks to fix dimensions.
    [Name_plate.DXF, Name_plate.SLDPRT, Name_plate.STL]
2012-07-28 Minor reduction to the Calf_horn dimensions for packing purposes.
    [Calf_horn.DXF, Calf_horn.SLDPRT, Calf_horn.STL]
2012-08-04 Minor post-drop test structural improvements.
    All assemblies rebuilt.
    [Body_horn.DXF, Body_horn.SLDPRT, Body_horn.STL, Body_pivot.DXF, Body_pivot.SLDPRT, Body_pivot.STL, Head.SLDASM, Hexy.SLDASM]
2012-08-07 Tweaked Body_pivot to avoid potential structural issues.
    The outer screws on the left and right edges were worryingly close to the edge after the previous change.
    [Body_pivot.DXF, Body_pivot.SLDPRT, Body_pivot.STL]
2012-08-13 Added engrave markings to denote the direction of the hip sides.
    These markings are a visual aid for assembly.
    The engrave markings point in towards the hip servo.
    [Hexy.SLDASM, Hip_back_side.DXF, Hip_back_side.SLDPRT, Hip_back_side.STL, Hip_horn_side.DXF, Hip_horn_side.SLDPRT, Hip_horn_side.STL, Leg.SLDASM]
2012-08-13 Tweaked the nameplate engravings by popular demand.
    [Hexy.SLDASM, Main_body.SLDASM, Name_plate.DXF, Name_plate.SLDPRT, Name_plate.STL]
2012-08-24 Increased the height of the body brace by 1mm.
    [Body_brace.DXF, Body_brace.SLDPRT, Body_brace.STL]
2012-08-24 First pass of new board/battery mounting scheme.
    Further changes pending final dimensions of the battery case and positioning of the Servotor screw holes.
    [Battery_bottom.DXF, Battery_bottom.SLDPRT, Battery_bottom.STL, Board plate.DXF, Board plate.SLDPRT, Board plate.STL, Body_brace.SLDPRT, Body_brace.STL]
2012-08-24 Minor structural reinforcement of hip side pieces.
    [Hip_back_side.DXF, Hip_back_side.SLDPRT, Hip_back_side.STL, Hip_horn_side.DXF, Hip_horn_side.SLDPRT, Hip_horn_side.STL, Leg.SLDASM]
2012-08-24 Main assembly rebuilt with the head on the right side.
    [Head.SLDASM, Hexy.SLDASM]
2012-08-26 Fixed all of the Hip_top_side mates being broken in the leg assembly.
    [Hexy.SLDASM, Leg.SLDASM]
2012-08-28 Mounting holes added to board plate.
    [Board plate.DXF, Board plate.SLDPRT, Board plate.STL]
2012-08-28 Added a fillet to the Body_horn battery slot inside corners.
    This reinforces a weak point introduced by the removal of the back of the piece.
    [Body_horn.DXF, Body_horn.SLDPRT, Body_horn.STL]
2012-09-01 Updated/corrected all mounting hardware in the head assembly.
    [Head.SLDASM]
2012-09-01 Added the battery standoff and fixed all servo horn mates.
    [Main_body.SLDASM]
2012-09-01 Updated all hardware mates in the main body assembly.
    [Main_body.SLDASM]
2012-09-01 Main assembly mate cleanup.
    [Hexy.SLDASM]
2012-09-01 Screwed the head to the body in the main assembly.
    [Hexy.SLDASM]
2012-09-22 Made an attachment for the screwdriver for more torque.
    The included screwdriver is quite small, so this should help for people with larger hands.
    [Screwdriver grip.DXF, Screwdriver grip.SLDPRT]
2012-09-22 Made the ArcBotics and OSHW logos into blocks.
    Hoping this makes SolidWorks choke less hard when I add the new Hexy logo.
    [Name_plate.SLDPRT]
2012-09-22 Updated nameplate with Jess Smiley's awesome Hexy logo.
    [Name_plate.DXF]
2019-05-07 Exported as STEP files
    [Battery_bottom.STEP, Battery_bottom_standoff.STEP, Board plate.STEP, Body_brace.STEP, Body_horn.STEP, Body_pivot.STEP, Calf_horn.STEP, Calf_pivot.STEP]
